prostoiChelovek/econet-2021/hardware/CAD/ball_bracket.FCStd

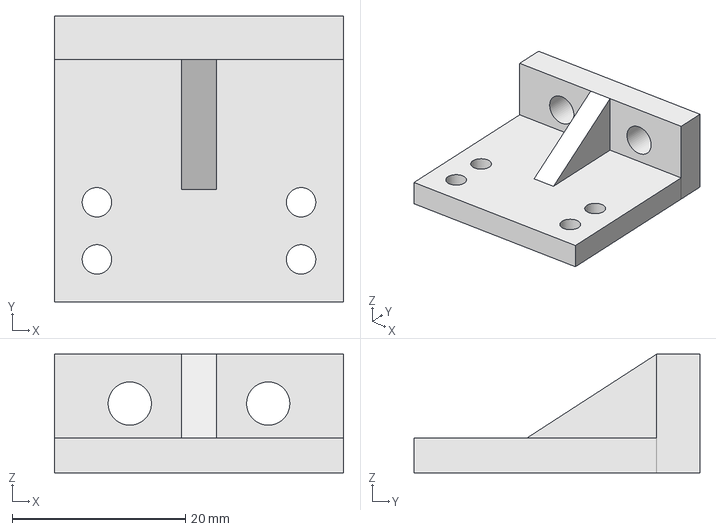
[picture p4: CAD file, 2022-01-08]
hardware/CAD/ball_bracket.FCStd
33.4 x 33.0 x 13.7 mm
