prostoiChelovek/econet-2021/hardware/CAD/stl/drawer_lower_limit_mount.stl

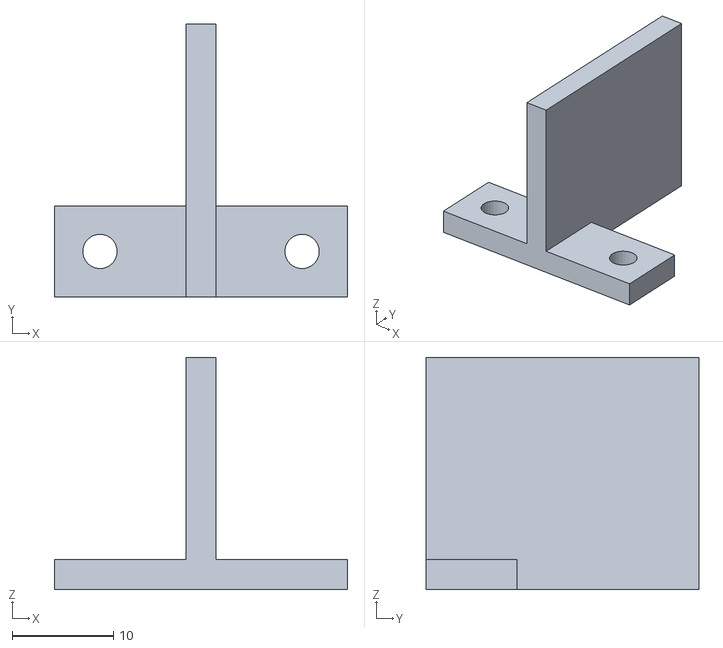
[picture p5: CAD file, 2022-01-20]
hardware/CAD/stl/drawer_lower_limit_mount.stl
29.0 x 27.0 x 23.0
