prostoiChelovek/econet-2021/hardware/CAD/stl/wire_bus_holder.stl

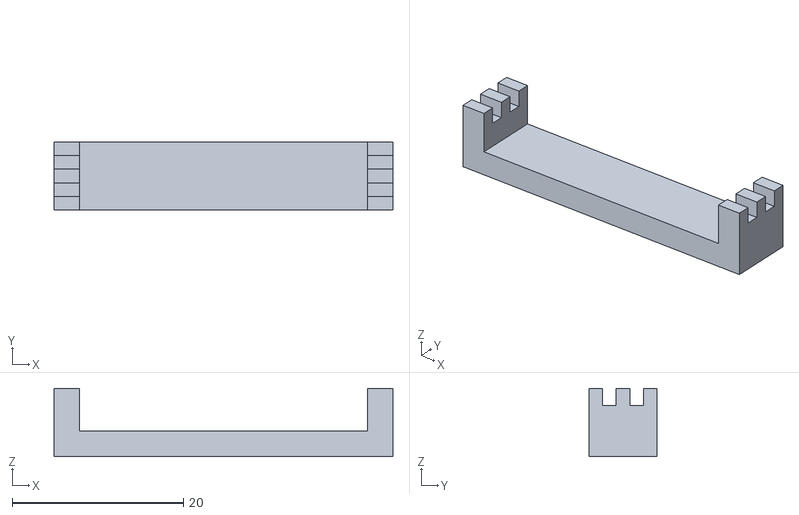
[picture p6: CAD file, 2022-01-13]
hardware/CAD/stl/wire_bus_holder.stl
39.6 x 8.00 x 8.00
