prostoiChelovek/econet-2021/hardware/CAD/stm_mount.FCStd

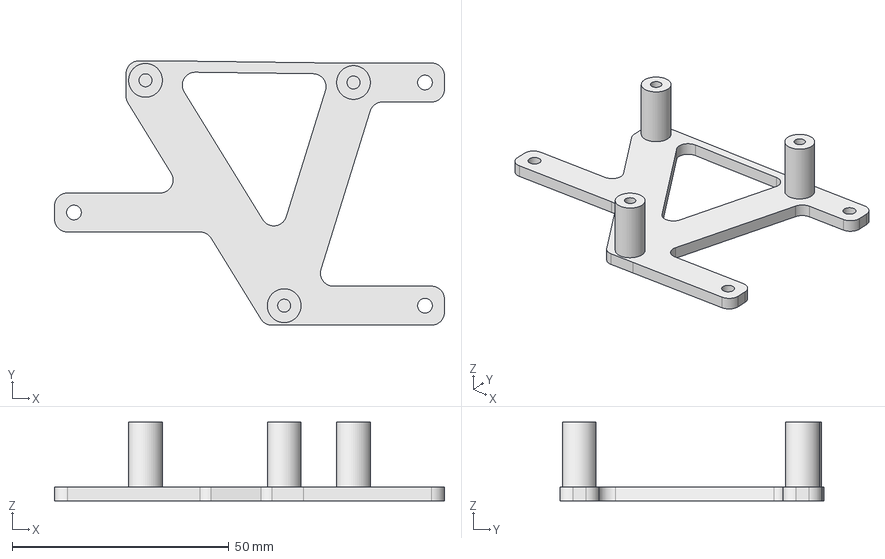
[picture p7: CAD file, 2022-01-08]
hardware/CAD/stm_mount.FCStd
90.0 x 61.0 x 18.2 mm
