prostoiChelovek/econet-2021/hardware/CAD/stl/drivers_mount.stl

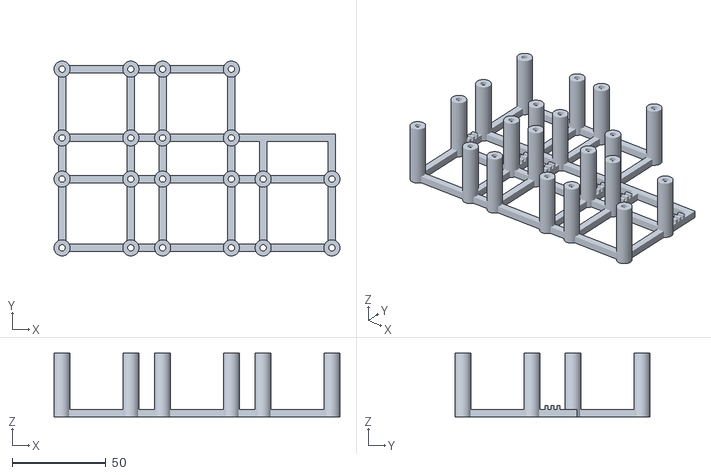
[picture p8: CAD file, 2022-01-09]
hardware/CAD/stl/drivers_mount.stl
152.2 x 103.7 x 34.0
