prostoiChelovek/econet-2021/(list of files, cad)

Other CAD files:
hardware/CAD/stl/ball_bracket.stl
hardware/CAD/stl/stm_mount.stl
