prostoiChelovek/econet-2021/(commit log)

2021-11-15 create a basic Cargo config for stm32
2021-11-19 use a BSP crate for the exact board we've got
2021-11-21 реализовать тестовую версию распознавания линий
2021-11-21 создать набросок распознавания линий по цвету
2021-11-21 use panic-probe instead of plain rtt and cleanup configs
2021-12-10 create a BOM
    [BOM.csv]
2021-12-14 configure I2c
    does not wanna speak to the motor controller for some reason
    kinda works on arduino
2021-12-18 Create photo.py
    програма для сбора фотографий мусора
2021-12-26 убрать лишнюю функцию typing
2021-12-26 отформатировать calchist
2021-12-26 refactor глобальных переменных
2021-12-26 исправить ошибки после рефакторинга
2021-12-26 вынести сортировку гистограммы в отдельную функцию
2021-12-26 заменить цикл на генераторы для значений плота
2021-12-26 заменить магическое число на константу
2021-12-26 вынести создание гистограммы в отдельную функцию
2021-12-26 переделать отображение гистограммы
2021-12-26 исправить порядок стобцов и колонок
2021-12-26 вынести код в функцию main
2021-12-27 create a simple test for the motor driver
2021-12-28 create traits and a wrapper struct for motors
2021-12-28 implement the motor traits for the l298n driver
2021-12-28 fix trait implementation of SetSpeed for Motor
    [lib.rs]
2021-12-29 fix pwm duty calculation and get rid of map_ranges
    [lib.rs]
2021-12-29 create a simple test for the new motor
2022-01-03 implement a funcion for getting current time in microseconds
2022-01-03 initialize a rotary encoder and create a simple test for it
2022-01-03 create a wrapper struct for rotary encoder
2022-01-04 refactor position calculation and implement velocity calculation
2022-01-06 refactor type specification of the Motor resource
2022-01-06 add Encoder to the local resources
2022-01-06 make encoder shared
2022-01-06 create traits for encoders
2022-01-06 create and implement a trait for getting current speed
2022-01-06 update the current_direction field
2022-01-06 invent a wheel
    may panic, WIP
2022-01-06 fix overflows of the speed value
    [lib.rs]
2022-01-06 remove debug prints
2022-01-07 make the input of the PID regulator a percentage value
    to match input and output dimensions
2022-01-07 make Wheel.get_speed return percentage value
    for consistency
2022-01-07 initialize USART for printing and create a printer task for debugging
2022-01-07 remove negation of the encoder velocity
    it was introduced because motor was wired backwards
2022-01-08 update current_speed before adding min_speed
2022-01-08 add a method for getting target speed of the Wheel
2022-01-08 create a task for emulating speed change for testing PID
2022-01-08 adjust the maximum speed value of the motor
2022-01-08 tune the PID regulator of the wheel
2022-01-08 add some of the 3D models
    [ball_bracket.FCStd, ball_bracket.stl, stm_mount.FCStd, stm_mount.stl]
2022-01-09 create a master sketch with the dimensions of the driver
    [drivers_mount.FCStd]
2022-01-09 create a base of the driver mount
    [drivers_mount.FCStd]
2022-01-09 fix dimensions of the cutout so that hoels' walls fit within completely
    the sketch has got kinda messy, but it works
    [drivers_mount.FCStd]
2022-01-09 create standoffs
    [drivers_mount.FCStd]
2022-01-09 wipe out everything and redo the base
    [drivers_mount.FCStd]
2022-01-09 create stadoffs
    [drivers_mount.FCStd]
2022-01-09 create vertical bridge
    [drivers_mount.FCStd]
2022-01-09 add a mount for the second driver
    [drivers_mount.FCStd]
2022-01-09 add wire guides
    [drivers_mount.FCStd]
2022-01-09 create horizontal bridges
    [drivers_mount.FCStd]
2022-01-09 fix wire guides
    [drivers_mount.FCStd]
2022-01-09 create a pattern
    [drivers_mount.FCStd]
2022-01-09 create a pattern, this time in draft
    [drivers_mount.FCStd]
2022-01-09 fix links in sketches
    [drivers_mount.FCStd]
2022-01-09 pattern bridges
    [drivers_mount.FCStd]
2022-01-09 combine everything
    [drivers_mount.FCStd]
2022-01-09 undo join and add forgotten bridges
    [drivers_mount.FCStd]
2022-01-09 wipe everything out again
    reverts to 9285790270e1db3aa4fcc3108e5e953a4e55311f
    [drivers_mount.FCStd]
2022-01-09 create stadoffs
    cherry-pick of f9aa8e5b2bf86f7e96e28aa490011d10ebc0e937
    [drivers_mount.FCStd]
2022-01-09 create a model of driver's bottom plate in openscad
    [drivers_mount.scad]
2022-01-09 create a mount for a single driver
    [drivers_mount.scad]
2022-01-09 create an array of mounts
    [drivers_mount.scad]
2022-01-09 create bridges between the mounts
    [drivers_mount.scad]
2022-01-09 create the last bar and move inter-mount bridges to modules
    [drivers_mount.scad]
2022-01-09 create wire guides
    [drivers_mount.scad]
2022-01-09 add an STL for the drivers' mount
    [drivers_mount.stl]
2022-01-09 remove the FreeCAD version of the drivers' mount
    i am gonna worship the openscad from now on
    [drivers_mount.FCStd]
2022-01-13 create a holder for the wire bus
    [wire_bus_holder.scad, wire_bus_holder.stl]
2022-01-14 create a macro for creating type alias for wheels
2022-01-14 separate pin ident into port and pin
2022-01-14 separate the rest of the macro parametrs to port and pin
2022-01-14 revert changes related to generation of the 'create' func for wheel
    this reverts commits 4084dea..6a2aab9
    [lib.rs, main.rs]
2022-01-15 add params for QEI's timer to the wheel_alias macro
2022-01-15 initialize the second wheel
2022-01-15 add logic for the right wheel
2022-01-16 make Wheel operate in linear units instead of radial
2022-01-16 move some wheels' params to consts and reuse the PID struct
2022-01-16 add a method to get the curent position of the Wheel
2022-01-16 implement proper selection of a signed pair for the count type
    allows to use it with timers that have different bitness
2022-01-16 create a wrapper around Wheel that controlls position
2022-01-16 create a quick-n-dirty test for WheelPositionController
2022-01-16 tune the PID regulator for the position control loop
2022-01-16 stop using target speed for scaling, replace it with wheel's max_speed
    WheelPositionController.max_speed -> Wheel.max_speed
    in [de]normalize_speed
    [lib.rs]
2022-01-16 introduce the I component to the position regulator
    to prevent it from slowing down too much
    when setpoints are distanced far apart
    [main.rs]
2022-01-16 rename WheelPositionController to Servo
    that name was long and ugly AF
2022-01-16 make a Servo out of the right wheel
2022-01-16 refactor the creation of the Servos a little
2022-01-16 create Chassis
2022-01-16 move Chassis and stuff into a separate file
2022-01-16 initialize chassis in main
2022-01-20 create a driver for the ITG3205 gyroscope
2022-01-20 make accel and gyro shared
2022-01-20 extract motor alias into a separate macro
2022-01-20 Revert "extract motor alias into a separate macro"
    This reverts commit 3eaa2e6285438b441f3796193f4e9dafddfd6bc8.
    [main.rs]
2022-01-20 create a mount for lower limit switches of drawers
    [drawer_lower_limit_mount.scad, drawer_lower_limit_mount.stl]
